mariolukas/openexposer/Software/Tools/grslicer/examples/octopusv10block_fixed_sc055.stl

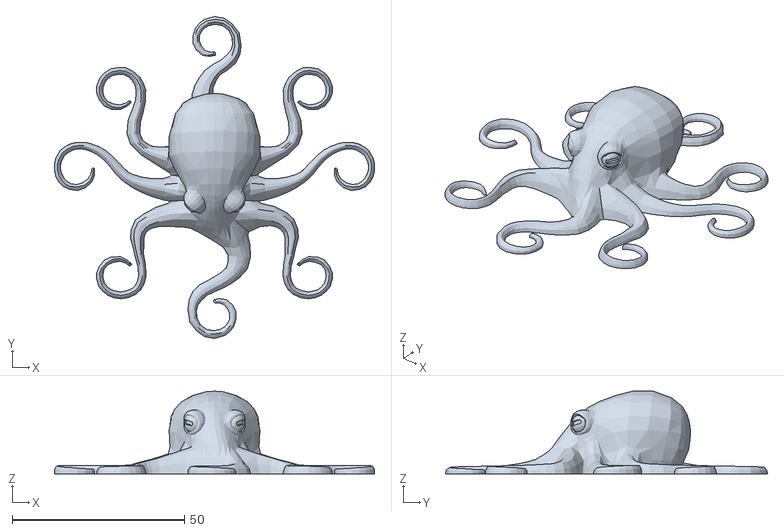
[picture p3: CAD file, 2016-01-04]
Software/Tools/grslicer/examples/octopusv10block_fixed_sc055.stl
93.0 x 93.4 x 24.0
