mariolukas/openexposer/Software/Tools/grslicer/grslicer/test/data/25mm_cube_ascii.stl

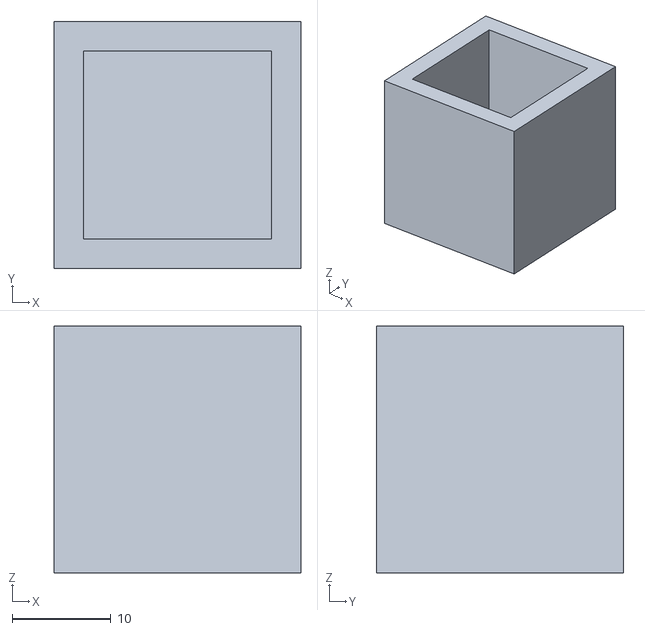
[picture p4: CAD file, 2015-12-31]
Software/Tools/grslicer/grslicer/test/data/25mm_cube_ascii.stl
25.0 x 25.0 x 25.0
