mariolukas/openexposer/Software/Tools/grslicer/examples/turm.stl

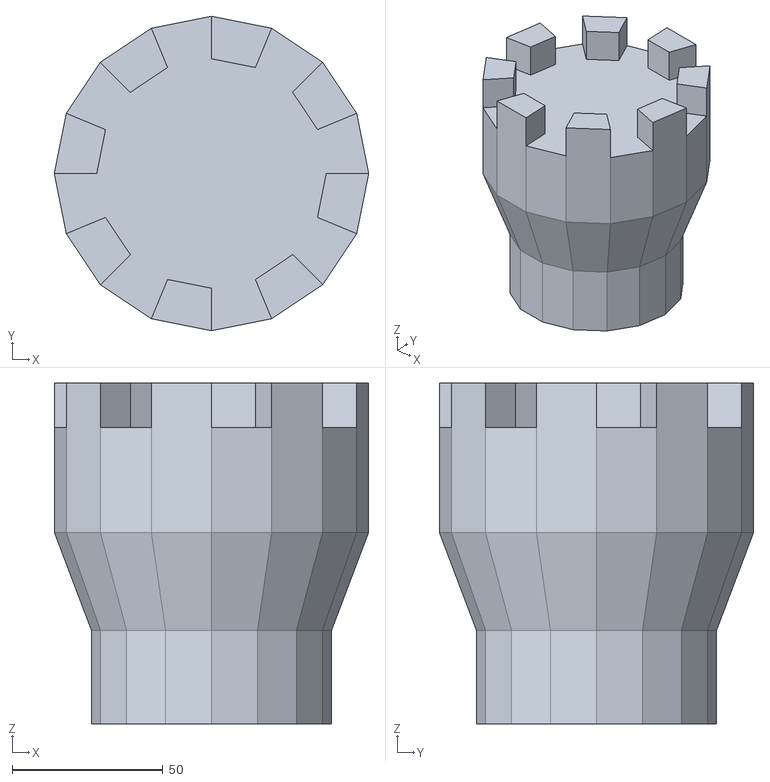
[picture p5: CAD file, 2015-12-31]
Software/Tools/grslicer/examples/turm.stl
104.2 x 104.2 x 113.0
