mariolukas/openexposer/Software/Tools/grslicer/grslicer/test/data/ctrlV_3D_test_ascii.stl

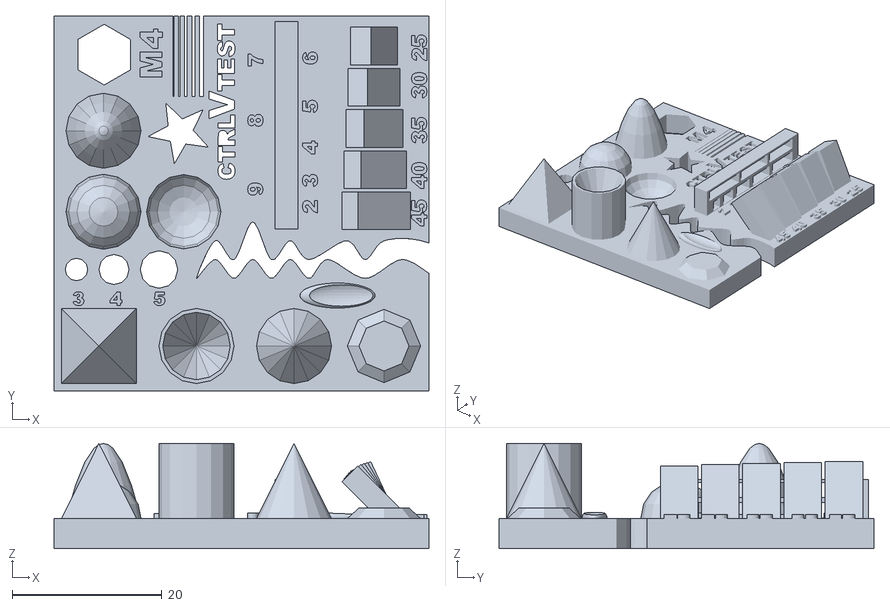
[picture p6: CAD file, 2015-12-31]
Software/Tools/grslicer/grslicer/test/data/ctrlV_3D_test_ascii.stl
50.0 x 50.0 x 14.0
