mariolukas/openexposer/Software/Tools/grslicer/examples/tower_round_v2.stl

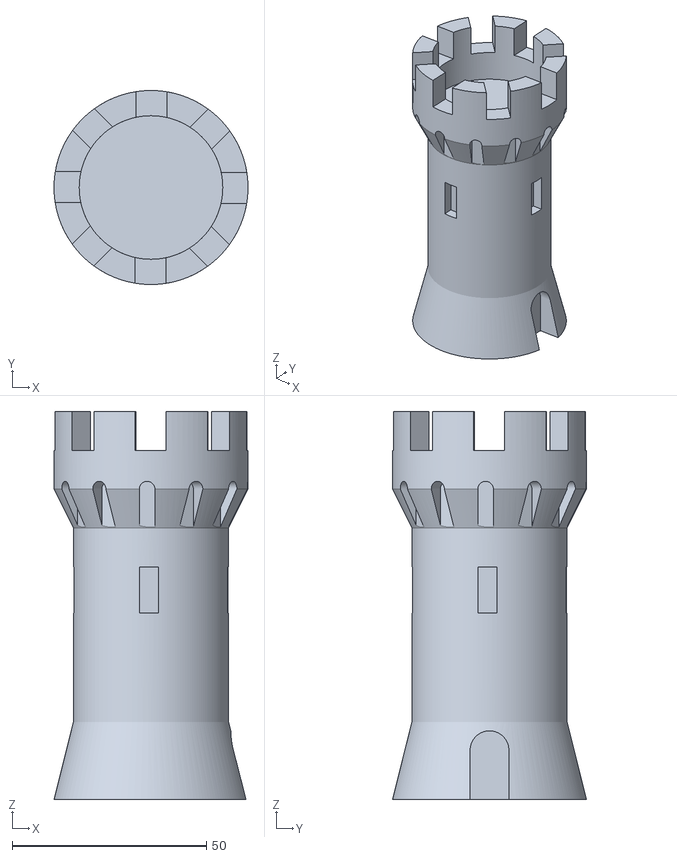
[picture p7: CAD file, 2015-12-31]
Software/Tools/grslicer/examples/tower_round_v2.stl
50.0 x 50.0 x 100.0
