mariolukas/openexposer/Hardware/3d_parts/config.scad

$fn = 50;
screw_distance_x = 60;
screw_distance_y = 40;
wall_thickness = 2.5;

case_width = screw_distance_x*2;
case_length = screw_distance_y*2.25+15;
case_height = 32;

bearing_diameter = 16;
bearing_length = 28;
