mariolukas/openexposer/(list of files, cad)

Other CAD files:
Software/Tools/grslicer/grslicer/test/data/25mm_cube_bin.stl
Software/Tools/grslicer/grslicer/test/data/ctrlV_3D_test.stl
