mariolukas/openexposer/(threads)

Thread 2 (2016-03-02):

replace laser ic potis by fixed valued resistors

mariolukas, 2016-03-02:

Thread 3 (2016-03-02):

add level shifter for nanite i2c communication

mariolukas, 2016-03-02:

cemonds, 2016-03-05:
We should just provide the option to use the level shifter from watterott. http://www.watterott.com/de/Level-Shifter They are cheap, simple to handle and use an ic explicitly designed for i²c. I would suggest, we add the pads for soldering the needed 2 3-pin sockets and make the traces inbetween cuttable. The voltage supply of the low side of the level shifter can be connected to the IOREF pin of the shield, the high side to the supply voltage of the nanite. This way people can use a level shifter if needed, but don't need to, if they have all ics using the same supply voltage.

Thread 5 (2016-03-02):

add additional pins to flatband connector

mariolukas, 2016-03-02:
for more polygon mirror support add additional pins to the flatband connector.
some GND and VCC pins are redundant

cemonds, 2016-03-05:
We need the following pins:
- laser VCC
- laser GND
- laser detector VCC
- laser detector TRIGGER
- polygon mirror VCC
- polygon mirror GND
- polygon mirror ENABLE
- polygon mirror CLOCK

Am i missing something? Perhaps we should include some spare pins for other needs?

Thread 6 (2016-03-02):

add traces to nanties i2c or serial bus

mariolukas, 2016-03-02:

cemonds, 2016-03-05:
I think i²c should be the way to go here. We can use the https://github.com/rambo/TinyWire library for the motor controller.

cemonds, 2016-03-06:
The arduino Uno uses the pins A4 (SDA), A5 (SCL) for i²c. Right now A5 is used for microstep configuration and A4 is used for the endstop in Y direction. The microstep feature could be solved in hardware with some jumpers, since there is no need to make this configurable in software. The endstop can easily be moved to another pin e.g. A2.

Thread 7 (2016-03-05):

Add 2-pin header to cut off laser driver Vss

cemonds, 2016-03-05:
As an enhancement for laser safety it should be possible to cut off the supply voltage of the laser driver via a micro switch integrated into the case. The easiest way to do this is to add some pads for a pin header with 2 pins into the trace. If you want to use a micro switch you can cut the trace between the two pads, assemble the pin header and connect the switch.

Thread 8 (2016-03-05):

Use bounding volume hierarchy to speed up slicer

cemonds, 2016-03-05:
The slicing algorithm does a bad job at the moment when intersecting the rays with the mesh triangles. This could be dramatically improved by using something like a bounding volume hierarchy or an octree to determine which triangles have to be checked for intersection.
A first start could be this cross compiled python version of the original java code from http://thomasdiewald.com/blog/?p=1488.
[bvh.py.zip](https://github.com/mariolukas/openexposer/files/159913/bvh.py.zip)

DanielJoyce, 2016-03-27:
I have a totally GPU based slicer I have been working on that only generates raster images, but the black and white images could be used to drive a scanline style laser printer very easily. Is there any documentation on the g-code commands used to drive the actual printer?

https://goo.gl/photos/9WXNBp7vEHuyTqBw8

I even have ideas on how to do shelling, including hollow pattern filled shells, and interior vs exterior supports via various slicing and other tricks. I thick I even have a method for automatic support generation.

There are no geometry calculations involved. It can be expanded to rafting as well.

cemonds, 2016-03-28:
Right now there isn't any documentation besides the code. The g-code coordinates are relative with the origin being centered in the middle of the build platform. Distances are always in µm. The laser line g-code works as following:

1. It moves relative to the next scan line in y direction with the command G01 Y<distance>;
2. It sends each x coordinate where the laser is toggled as a single command G05 D<distance>; So for a line that spans from position -4000 to 2000 relative to the origin the following commands are send: G05 D-4000; G05 D6000;
3. Starting the exposing process is done with the command G06 E<cycles>; where cycles defines how many times this scanline is exposed.

The slicer right now uses just STLs and calculates the intersections of the scan line rays with all triangles of the stl mesh. No support generation is available at the moment, but it can be done with an external tool. It was more a proof of concept than a finished slicing tool.
Using the GPU is an interesting idea. Have you some code one could take a look at?

DanielJoyce, 2016-03-28:
Yes, yes I do. Its alpha.

https://goo.gl/photos/tbtD5fjcRpuH7Bwv5, play icon in upper right

https://github.com/DanielJoyce/microtome

Support generation and slicing all done via camera, shader, etc tricks. I
also now have a decent idea on handling "Shelling" and support generation
that properly handles unsupported areas during the print that the current
simple scheme doesn't catch always.

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
--
Daniel Joyce

The meek shall inherit the Earth, for the brave will be among the stars.

sajjadul-wematter, 2016-06-17:
I already have experience of implementing a whitted ray tracer using the bounding volume hierarchy in C++. I am also trying to use the very same concept(ray tracing) to do a uniform / adaptive  slicing of 3D  CAD model. Some references/hints will be very helpful.

Thanks

Thread 10 (2016-05-08):

Change restistors for IC-HK laser driver ic.

mariolukas, 2016-05-08:
Replace resistors for IC-HK/B laser driver ic.

enable -> 10 ohm
standby -> 120 ohm
