mariolukas/openexposer/Hardware/electronics/laser_driver/analog_driver_s.pdf

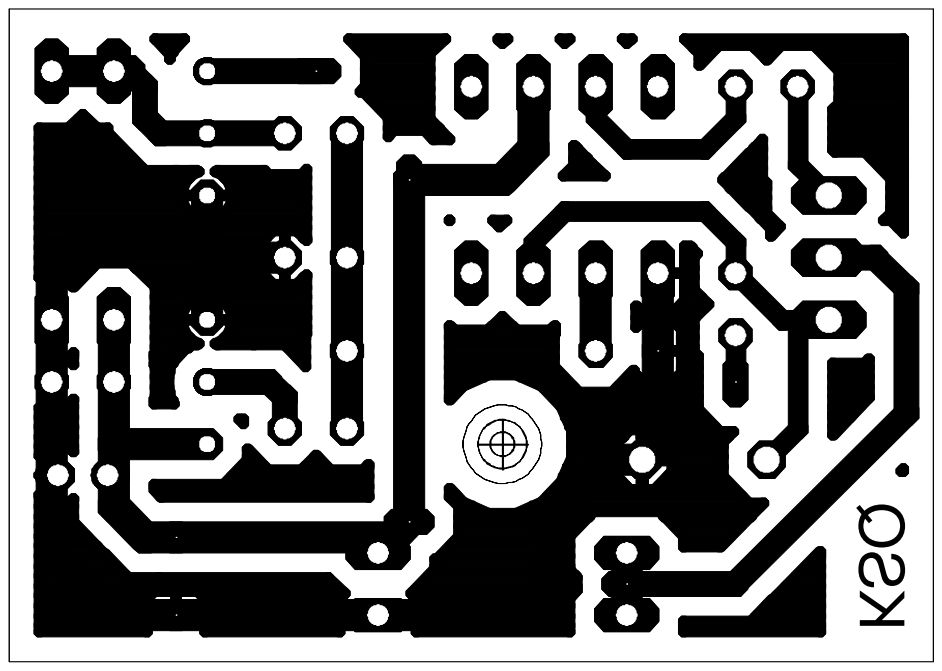
[picture p8: page 1]
KSQ
