mariolukas/openexposer/Software/Firmware/OpenExposer/configuration.h

/**
 * Configuration of OpenExposer firmware
 *
 *  Copyright 2014 by Mario Lukas <info@mariolukas.de>
 *
 * This file is part of OpenExposer firmware.
 *
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
 * @license GPL-3.0+ <http://opensource.org/licenses/GPL-3.0>
 */

#ifndef OPENEXPOSER_CONFIGURATION_H
#define OPENEXPOSER_CONFIGURATION_H
        
// GENERAL
#define VERSION              (0.3)  // firmware version
#define BAUD                 (9600)  // How fast is the Arduino talking?
#define MAX_SERIAL_BUFFER    (64)  // What is the longest message Arduino can store?
        
        
// STEPPER  


#define VAT_SERVO_PIN A0

#define Z_ENABLE_PIN  2
#define Z_STEP_PIN    3
#define Z_DIR_PIN     4

#define Y_ENABLE_PIN   5  
#define Y_STEP_PIN     6  
#define Y_DIR_PIN      7


#define Y_STEPS_PER_MM 4000
#define Z_STEPS_PER_MM 16000

#define Y_RESOLUTION Z_STEPS_PER_MM  // equals 1/10 mm
#define Z_RESOLUTION Y_STEPS_PER_MM  // equals 1/10 mm

#define STEPS_PER_TURN 200
#define MICROSTEP   A5 


// ENDSTOPS
#define Y_ENDSTOP  A4
#define Z_ENDSTOP  A3

// LASER
#define LASER_PIN         9
#define LASER_ENABLE_PIN 10
#define LASER_PORT        B
#define LASER_BIT         1
#define LASER_PWM_PORT    D
#define LASER_PWM_BIT     6
#define LASER_PWM_PIN     6

#define LASER_EXPOSING_CYCLES 1000
#define LASER_POINT_SCALER 15

#define LASER_TIMING_SCALE_DIVIDEND 1
#define LASER_TIMING_SCALE_DIVISOR 8

#define LASER_TIMING_CENTER_OFFSET 24000

#define LASER_POSITIONS_BUFFER_SIZE 255

// OPTO TRIGGER PIN
#define OPTO_PIN 8

#define SERVO_MAX_POS 90
#define SERVO_MIN_POS 30

// USEFUL MACROS DO NOT CHANGE

#define PORT_(port) PORT ## port 
#define DDR_(port)  DDR  ## port 
#define PIN_(port)  PIN  ## port 

#define PORT(port) PORT_(port) 
#define DDR(port)  DDR_(port) 
#define PIN(port)  PIN_(port)

#define SET_DDR(p)    DDR(p##_PORT) |= (1<<p##_BIT)
#define CLEAR_DDR(p)  DDR(p##_PORT) &= ~(1<<p##_BIT)
#define OUTPUT_ON(p)  PORT(p##_PORT) |= (1<<p##_BIT)
#define OUTPUT_OFF(p) PORT(p##_PORT) &= ~(1<<p##_BIT)
#define _INPUT(p)    ((PIN(p##_PORT) & (1<<p##_BIT)) != 0)

#endif // OPENEXPOSER_CONFIGURATION_H
