mariolukas/openexposer/Software/Firmware/OpenExposer/LaserTimer.h

/**
 * OpenExposer firmware
 *
 *  Copyright 2016 by Christoph Emonds <info@christoph-emonds.de>
 *
 * This file is part of OpenExposer firmware.
 *
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
 * @license GPL-3.0+ <http://opensource.org/licenses/GPL-3.0>
 */

#ifndef OPENEXPOSER_LASERTIMER_H
#define OPENEXPOSER_LASERTIMER_H

#include <avr/io.h>

class LaserTimer
{

public:
    static void startTimer() __attribute__((always_inline));
    static void setValue(uint16_t value) __attribute__((always_inline));
    static void disableTimerPin() __attribute__((always_inline));
    static void forceClearPinOnMatch() __attribute__((always_inline));
    static void setOnCompareMatch() __attribute__((always_inline));
    static void toggleOnCompareMatch() __attribute__((always_inline));
    static void enableInputCapture() __attribute__((always_inline));
    static void disableInputCapture() __attribute__((always_inline));
    static void clearInputCaptureFlag() __attribute__((always_inline));
    static void clearInputCaptureAndOutputCompareBFlag() __attribute__((always_inline));
    static uint16_t getInputCaptureTime() __attribute__((always_inline));
    static void enableInputCaptureAndOutputCompareBInterrupt() __attribute__((always_inline));
    static void disableInputCaptureAndOutputCompareBInterrupt() __attribute__((always_inline));
    static void setOutputCompareRegisterA(uint16_t value) __attribute__((always_inline));
    static uint16_t getOutputCompareRegisterA() __attribute__((always_inline));
    static void addToOutputCompareRegisterA(uint16_t value) __attribute__((always_inline));
    static void setOutputCompareRegisterB(uint16_t value) __attribute__((always_inline));
    static uint16_t getOutputCompareRegisterB() __attribute__((always_inline));
    static void waitForCompareRegisterAMatch() __attribute__((always_inline));
};

inline void LaserTimer::startTimer()
{
    TCCR1B = 1;
}

inline void LaserTimer::setValue(uint16_t value)
{
    TCNT1 = value;
}

inline void LaserTimer::disableTimerPin()
{
    TCCR1A = 0;
}

inline void LaserTimer::forceClearPinOnMatch()
{
    TCCR1A = (1<<COM1A1);
    TCCR1A = (1<<COM1A1) | (1<<FOC1A);
}

inline void LaserTimer::setOnCompareMatch()
{
    TCCR1A = (1<<COM1A1) | (1<<COM1A0);
}

inline void LaserTimer::toggleOnCompareMatch()
{
    TCCR1A = (1<<COM1A0);
}

inline void LaserTimer::disableInputCapture()
{
    TIMSK1 &= ~(1<<ICIE1);
}

inline void LaserTimer::enableInputCapture()
{
    TIMSK1 |= (1<<ICIE1);
}

inline void LaserTimer::clearInputCaptureFlag()
{
    TIFR1 = (1<<ICF1);
}

inline void LaserTimer::clearInputCaptureAndOutputCompareBFlag()
{
    TIFR1 = (1<<OCF1B) | (1<<ICF1);
}

inline uint16_t LaserTimer::getInputCaptureTime()
{
    return ICR1;
}

inline void LaserTimer::enableInputCaptureAndOutputCompareBInterrupt()
{
    TIMSK1 |= (1<<OCIE1B) | (1<<ICIE1);
}

inline void LaserTimer::disableInputCaptureAndOutputCompareBInterrupt()
{
    TIMSK1 &= ~ ((1<<OCIE1B) | (1<<ICIE1));
}

inline void LaserTimer::setOutputCompareRegisterA(uint16_t value)
{
    OCR1A = value;
}

inline uint16_t LaserTimer::getOutputCompareRegisterA()
{
    return OCR1A;
}

inline void LaserTimer::addToOutputCompareRegisterA(uint16_t value)
{
    OCR1A += value;
}

inline void LaserTimer::setOutputCompareRegisterB(uint16_t value)
{
    OCR1B = value;
}

inline uint16_t LaserTimer::getOutputCompareRegisterB()
{
    return OCR1B;
}

inline void LaserTimer::waitForCompareRegisterAMatch()
{
    while ((TIFR1 & (1 << OCF1A)) == 0);  //and wait for compare flag is set
    TIFR1 = (1 << OCF1A); // clear the flag
}




#endif //OPENEXPOSER_LASERTIMER_H
