mariolukas/openexposer/(commit log)

2014-03-19 Removed StepperDriver Library
2014-04-18 Added StepperControland ProcessCommand Files
2014-04-18 Added Endstop functions
    [configuration.h]
2014-04-19 cleaned code and added endstop and axis homing functions
    [configuration.h]
2014-04-19 - added homeing y axis to setup
2014-04-19 - added z endstop - added speed and acceleration values to config - added new function moveToNextLayer
    [configuration.h]
2014-04-19 - fixed serial event loop - added command parser - refactored process data main loop
    [configuration.h]
2014-04-19 - added function for toggeling direction
    [configuration.h]
2014-05-05 - cleaned folder structure
    [configuration.h]
2014-05-05 -changed folder structure
    [configuration.h]
2014-05-05 - added openscad file for exposer unit
    [exposer_unit.scad]
2014-05-05 - added laser driver eagle files and pdf
    [analog_driver_s.brd, analog_driver_s.sch]
2014-05-05 - removed files which are not needed
    [analog_driver_s.brd]
2014-05-05 - cleaned scad code
    [case.scad, config.scad, laser_mount.scad, mirror_mount.scad]
2014-05-05 - changed Readme.md
    [configuration.h]
2014-05-05 - added motor enable/disable function
2014-05-05 - added stl files
    [bottom_case.stl, case.scad, case.stl, laser_mount.stl, mirror_mount.scad, mirror_mount.stl, mirror_mount_sensor.stl]
2015-04-22 updated to new open exposer version
    [NEMAMount.scad, Nut_Job.scad, analog_driver_s.brd, analog_driver_s.sch, complete_view.scad, config.scad, cube.scad, cube.stl]
2015-04-22 removed some files
    [analog_driver_s.brd, analog_driver_s.sch, bottom_case.stl, case.scad, case.stl, config.scad, laser_mount.scad, laser_mount.stl]
2015-11-29 - added variables to show only specific parts of the hardware - allow display assembled as well as only parts
    [complete_view.scad]
2015-12-29 fixed firmware source
    [configuration.h]
2015-12-31 - added a rudimentary gcode viewer - added a first version of grslicer creating g-code for openexposer - added a python script to generate a test pattern as gcode
    [25mm_cube_ascii.stl, 25mm_cube_bin.stl, ctrlV_3D_test.stl, ctrlV_3D_test_ascii.stl, tower_round_v2.stl, turm.stl]
2016-01-03 - import facets normals from stl - use 64bit precision for calculations - use center of layer with a little offset for calculating scanlines
2016-01-04 - Fixed import of ascii stl - added octopus example
    [octopusv10block_fixed_sc055.stl]
2016-01-04 - use face vertices y coordinates to filter before intersection
2016-01-04 removed old slicer code
    [cube.scad, cube.stl, cylinder.stl, raute.stl, test.scad, test.stl]
2016-01-04 cleaned repository
    [25mm_cube_ascii.stl, 25mm_cube_bin.stl, ctrlV_3D_test.stl, ctrlV_3D_test_ascii.stl, octopusv10block_fixed_sc055.stl, tower_round_v2.stl, turm.stl]
2016-02-15 - added cmake build scripts for unit tests and arduino sketch - added first unit test dummy
2016-02-16 - moved google test, unit tests and arduino toolchain upwards
2016-02-17 - arduino build script now called by parent build
2016-02-24 - added some fake headers and symbols for compilation of firmware with unit tests - ignore clion ide files - removed ServoTimer2 library
    [configuration.h]
2016-02-24 - laser timings now adaptable with some variables
    [configuration.h]
2016-02-25 - Replaced define constants for laser state with new enum class LaserState
    [LaserDriver.cpp, LaserDriver.h]
2016-02-25 - added field to store the length of the buffer to laser_buffer_type - removed laser_data_position
2016-02-25 - added assertion to check maximum length of laser_buffer
    [configuration.h]
2016-02-29 - added -std=c++11 as compiler flag - search for arduino sdk in home directory of current user
2016-03-05 - documented cmake build - added feature to use arduino sdk path from environment variable - hex file now created in build directory
2016-03-05 - added troubleshooting if arduino sdk has not been found
2016-03-06 - added license GPLv3
    [configuration.h]
2016-03-06 - moved bitbanging of registers to inline functions of a LaserTimer class - added integration tests for LaserTimer
2016-05-03 - added firmware for motor controller
2016-05-08 modified polygon motor driver, increased duty cycle
2016-05-16 - added first version firmware working with example gcode "octopus"
    [configuration.h]
